Alexou1209/RPI-Pico-oscillocope-and-logic-analizer/3d_models/Case.FCStd

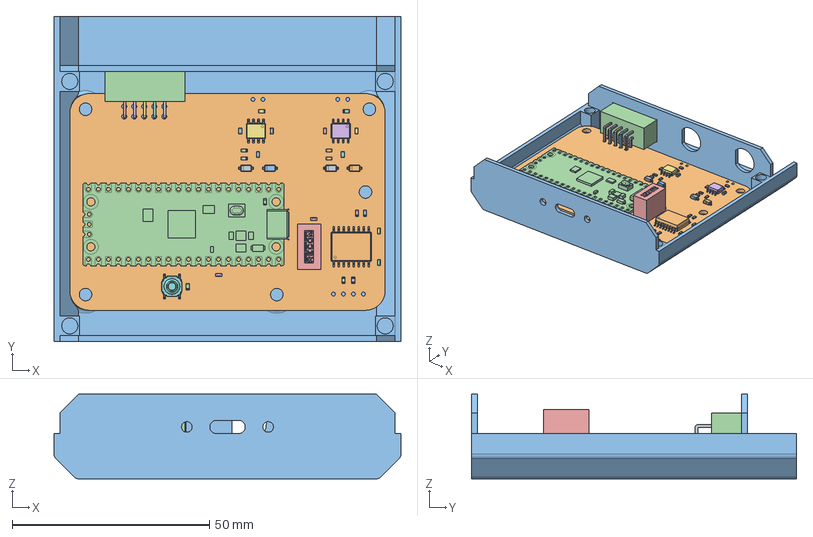
[picture p2: CAD file, 2026-10-25]
3d_models/Case.FCStd
88.0 x 82.5 x 21.5 mm
R_0603_1608Metric
SOIC-16W_7.5x10.3mm_P1.27mm
D_SOD-123
R_0603_1608Metric002
C_0603_1608Metric
R_0603_1608Metric004
SOIC-8_3.9x4.9mm_P1.27mm
R_0603_1608Metric006
RFM_potting
RFM_pin1(-Vin)
RFM_pin2(+Vin)
RFM_pin3(-Vout)
RFM_case
RFM_pin4(+Vout)
C_0603_1608Metric002
C_0603_1608Metric004
D_SOD-125
D_SOD-127
R_0603_1608Metric008
R_0603_1608Metric010
R_0603_1608Metric012
SOIC-8_3.9x4.9mm_P1.27mm002
R_0603_1608Metric014
SWT0220
D_SOD-129
R_0603_1608Metric016
R_0603_1608Metric018
RaspberryPi_Pico_Module_KiCad
R_0603_1608Metric020
C_0603_1608Metric006
C_0603_1608Metric008
R_0603_1608Metric022
C_0603_1608Metric010
R_0603_1608Metric024
R_0603_1608Metric026
LeadsArray
LeadsArray001
LeadsArray002
LeadsArray003
LeadsArray004
LeadsArray006
LeadsArray007
LeadsArray008
LeadsArray009
LeadsArray010
R_0603_1608Metric028
C_0603_1608Metric012
TSSOP-20_4.4x6.5mm_P0.65mm
Pico_Discovery-unsaved-export-cLAQ7U_PCB
Case_bottom
