Alexou1209/RPI-Pico-oscillocope-and-logic-analizer/3d_models/Pico_Discovery.step

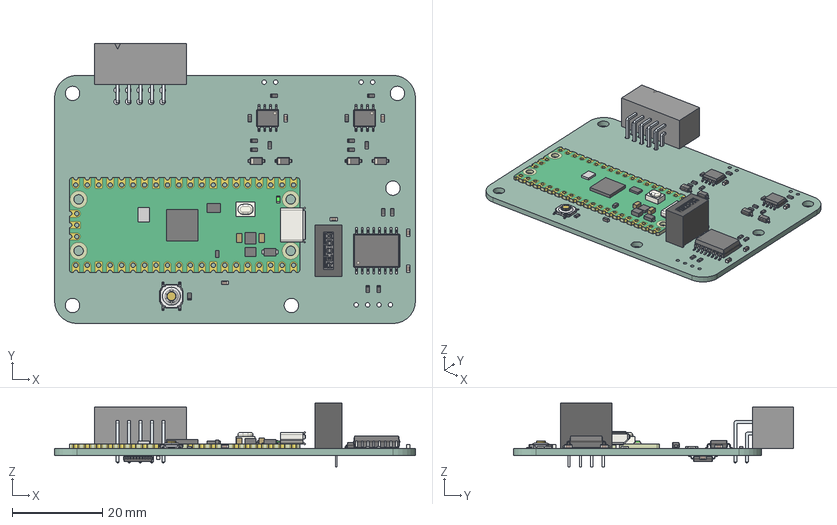
[picture p3: CAD file, 2026-10-25]
3d_models/Pico_Discovery.step
80.0 x 62.1 x 14.1 mm
R_0603_1608Metric x 15
SOIC-16W_7.5x10.3mm_P1.27mm
D_SOD-123 x 4
C_0603_1608Metric x 7
SOIC-8_3.9x4.9mm_P1.27mm x 2
RFM_potting
RFM_pin1(-Vin)
RFM_pin2(+Vin)
RFM_pin3(-Vout)
RFM_case
RFM_pin4(+Vout)
SWT0220
RaspberryPi_Pico_Module_KiCad
LeadsArray x 2
TSSOP-20_4.4x6.5mm_P0.65mm
Pico_Discovery-unsaved-export-cLAQ7U_PCB
