Alexou1209/RPI-Pico-oscillocope-and-logic-analizer/hardware/RPI_Pico_Oscilloscope.kicad_pcb

## KiCad design hardware/RPI_Pico_Oscilloscope.kicad_pcb (2026-10-25)

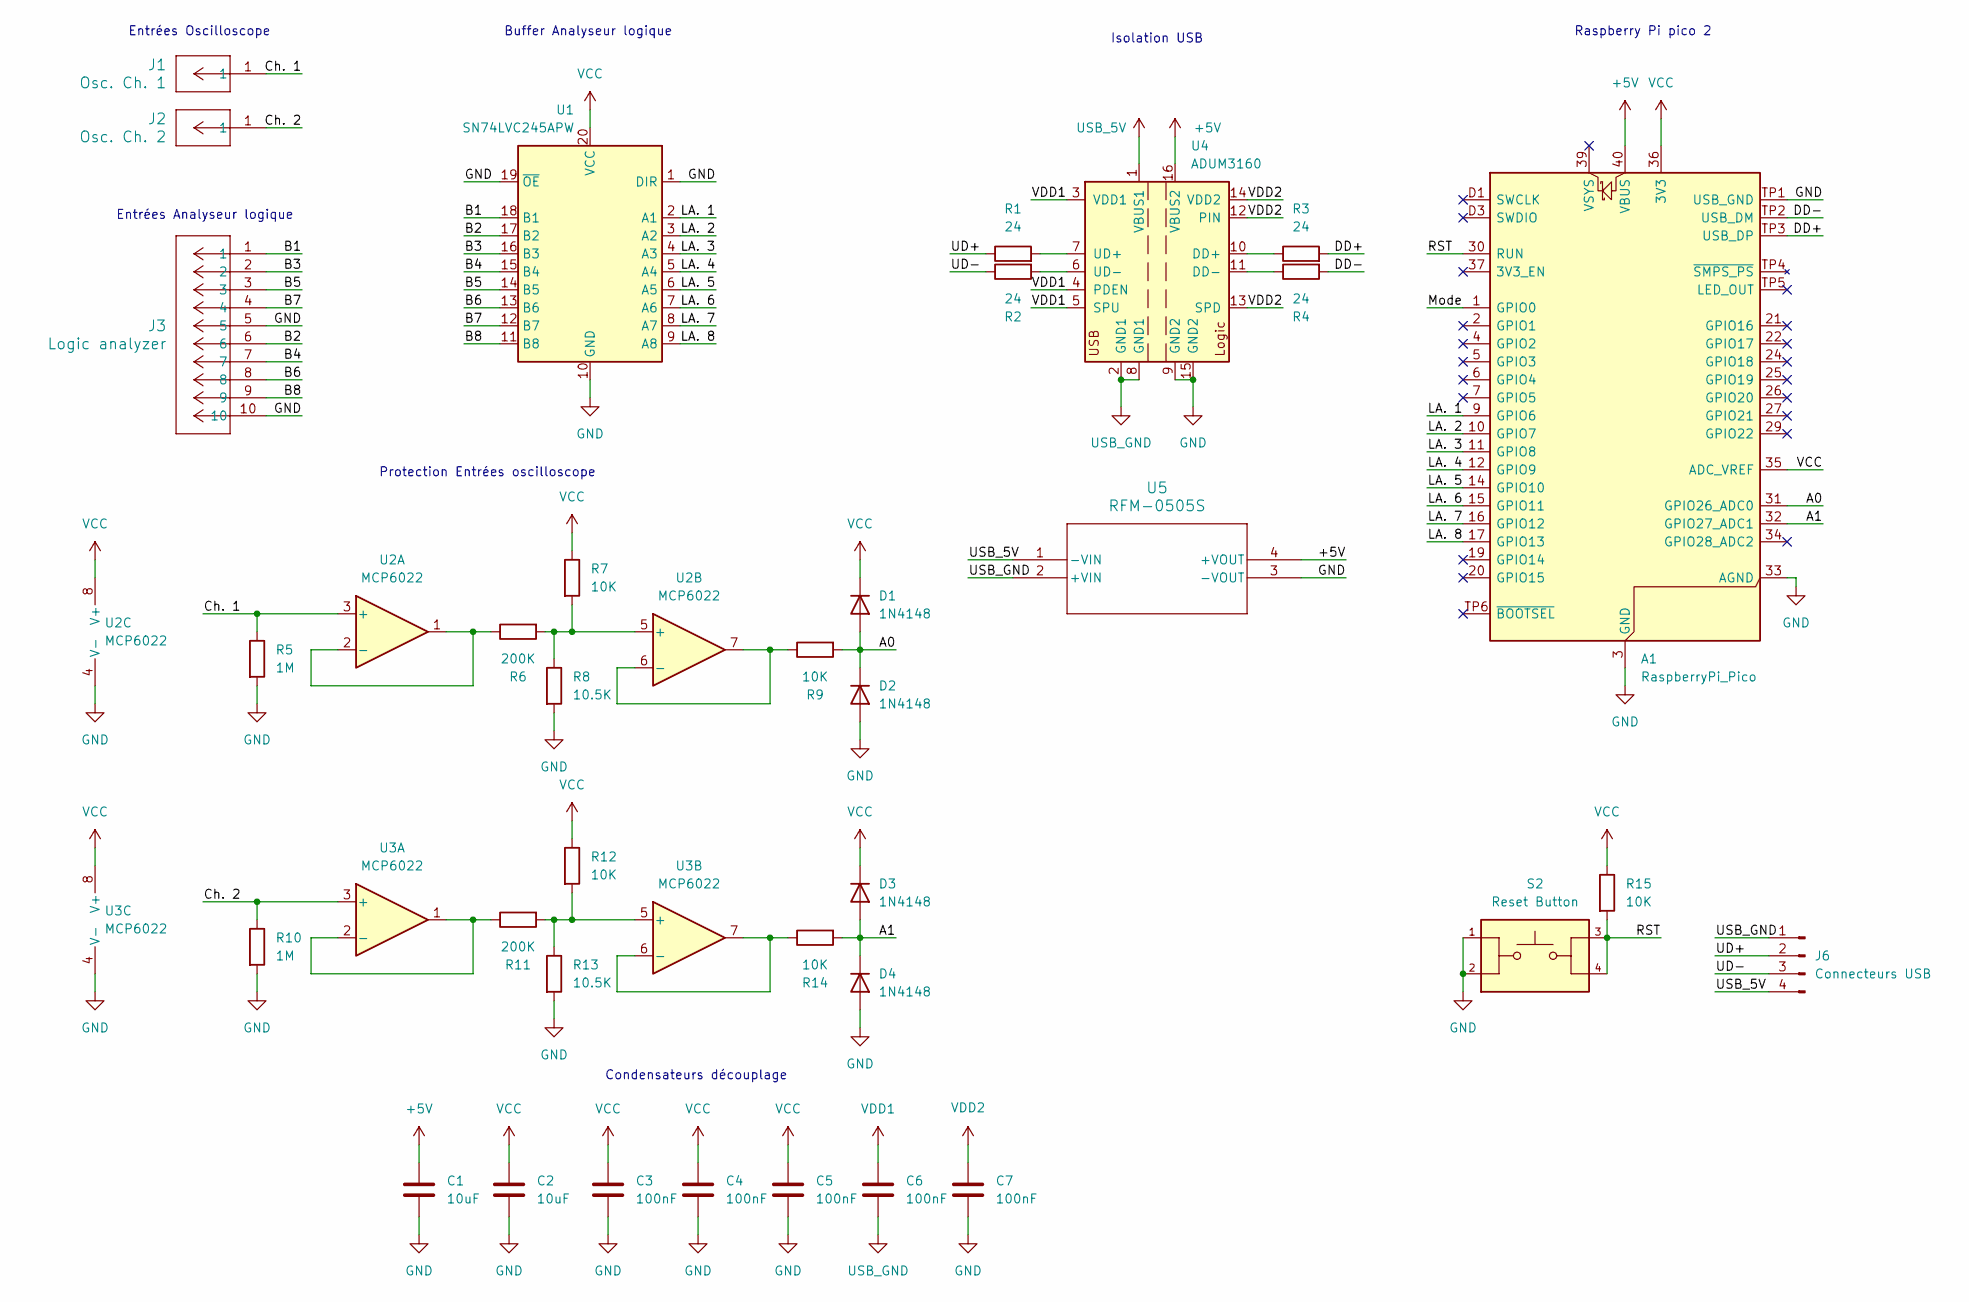
[picture p4: schematic RPI_Pico_Oscilloscope.kicad_sch, Pico_Discovery]

Parts:
A1: RaspberryPi_Pico; RaspberryPi_Pico_SMD
C1, C2: 10uF; C_0603_1608Metric_Pad1.08x0.95mm_HandSolder
C3, C4, C5, C6, C7: 100nF; C_0603_1608Metric_Pad1.08x0.95mm_HandSolder
D1, D2, D3, D4: 1N4148; D_SOD-123
J1: Osc. Ch. 1; PinHeader_1x02_P2.54mm_Vertical
J2: Osc. Ch. 2; PinHeader_1x02_P2.54mm_Vertical
J3: Logic analyzer; CONN_302-R101_OST
J6: Connecteurs USB; PinHeader_1x04_P2.54mm_Vertical
R1, R2, R3, R4: 24; R_0603_1608Metric_Pad0.98x0.95mm_HandSolder
R5, R10: 1M; R_0603_1608Metric_Pad0.98x0.95mm_HandSolder
R6, R11: 200K; R_0603_1608Metric_Pad0.98x0.95mm_HandSolder
R7, R9, R12, R14, R15: 10K; R_0603_1608Metric_Pad0.98x0.95mm_HandSolder
R8, R13: 10.5K; R_0603_1608Metric_Pad0.98x0.95mm_HandSolder
S2: Reset Button; SW_SWT0220-016016GSA_REVA; PARTREV A
U1: SN74LVC245APW; TSSOP-20_4.4x6.5mm_P0.65mm
U2, U3: MCP6022; SOIC-8_3.9x4.9mm_P1.27mm
U4: ADUM3160; SOIC-16W_7.5x10.3mm_P1.27mm
U5: RFM-0505S; SIP4_RFM_RCP

Connections:
+5V: A1.40 (VBUS), C1.2, U4.16 (VBUS2), U5.4 (+VOUT)
/<NO NET>: A1.30 (RUN), R15.2, S2.3, S2.4
/A0: A1.31 (GPIO26_ADC0), D1.2 (A), D2.1 (K), R9.2
/A1: A1.32 (GPIO27_ADC1), D3.2 (A), D4.1 (K), R14.2
/B1: J3.1, U1.18 (B1)
/B2: J3.6, U1.17 (B2)
/B3: J3.2, U1.16 (B3)
/B4: J3.7, U1.15 (B4)
/B5: J3.3, U1.14 (B5)
/B6: J3.8, U1.13 (B6)
/B7: J3.4, U1.12 (B7)
/B8: J3.9, U1.11 (B8)
/Ch. 1: J1.1 (1_1), R5.1, U2.3 (+)
/Ch. 2: J2.1 (1_1), R10.1, U3.3 (+)
/DD+: A1.TP3 (USB_DP), R3.2
/DD-: A1.TP2 (USB_DM), R4.2
/LA. 1: A1.9 (GPIO6), U1.2 (A1)
/LA. 2: A1.10 (GPIO7), U1.3 (A2)
/LA. 3: A1.11 (GPIO8), U1.4 (A3)
/LA. 4: A1.12 (GPIO9), U1.5 (A4)
/LA. 5: A1.14 (GPIO10), U1.6 (A5)
/LA. 6: A1.15 (GPIO11), U1.7 (A6)
/LA. 7: A1.16 (GPIO12), U1.8 (A7)
/LA. 8: A1.17 (GPIO13), U1.9 (A8)
/Mode: A1.1 (GPIO0)
/UD+: J6.2, R1.1
/UD-: J6.3, R2.1
GND: A1.3 (GND), A1.8 (GND), A1.13 (GND), A1.18 (GND), A1.23 (GND), A1.28 (GND), A1.33 (AGND), A1.38 (GND), A1.D2 (GND), A1.TP1 (USB_GND), C1.1, C2.1, C3.1, C4.1, C5.1, C7.1, D2.2 (A), D4.2 (A), J3.5, J3.10, R5.2, R8.2, R10.2, R13.2, S2.1, S2.2, U1.1 (DIR), U1.10 (GND), U1.19 (~OE), U2.4 (V-), U3.4 (V-), U4.9 (GND2), U4.15 (GND2), U5.3 (-VOUT)
unnamed: R6.1, U2.1, U2.2 (-)
unnamed: R6.2, R7.2, R8.1, U2.5 (+)
unnamed: R9.1, U2.6 (-), U2.7
unnamed: R11.1, U3.1, U3.2 (-)
unnamed: R11.2, R12.2, R13.1, U3.5 (+)
unnamed: R14.1, U3.6 (-), U3.7
unnamed: R3.1, U4.10 (DD+)
unnamed: R4.1, U4.11 (DD-)
unnamed: R1.2, U4.7 (UD+)
unnamed: R2.2, U4.6 (UD-)
USB_5V: J6.4, U4.1 (VBUS1), U5.1 (-VIN)
USB_GND: C6.1, J6.1, U4.2 (GND1), U4.8 (GND1), U5.2 (+VIN)
VCC: A1.35 (ADC_VREF), A1.36 (3V3), C2.2, C3.2, C4.2, C5.2, D1.1 (K), D3.1 (K), R7.1, R12.1, R15.1, U1.20 (VCC), U2.8 (V+), U3.8 (V+)
VDD1: C6.2, U4.3 (VDD1), U4.4 (PDEN), U4.5 (SPU)
VDD2: C7.2, U4.12 (PIN), U4.13 (SPD), U4.14 (VDD2)

Notes on the sheet:
Condensateurs découplage
Raspberry Pi pico 2
Protection Entrées oscilloscope
Entrées Oscilloscope
Isolation USB
Entrées Analyseur logique
Buffer Analyseur logique

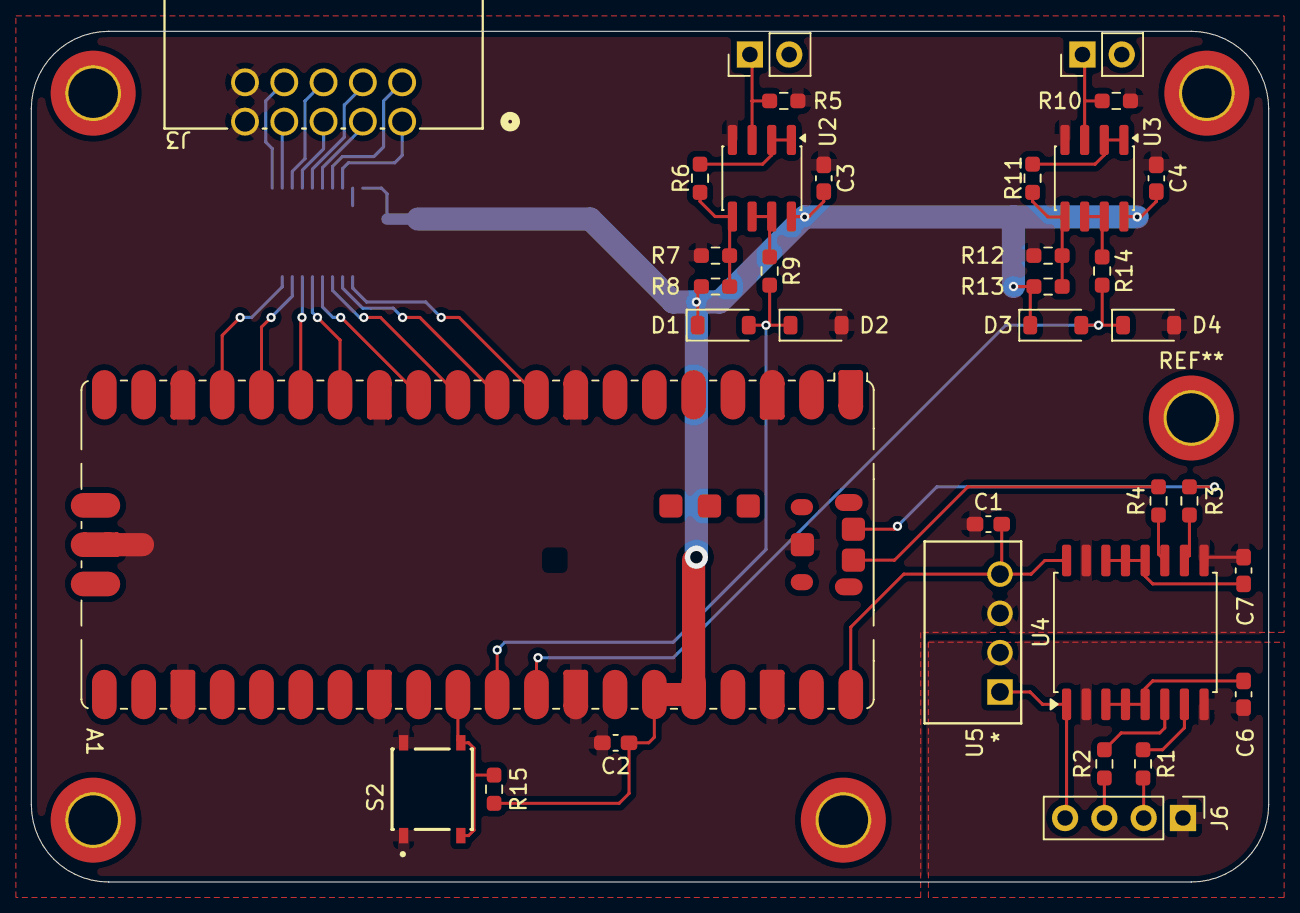
[picture p5: board RPI_Pico_Oscilloscope.kicad_pcb from above]

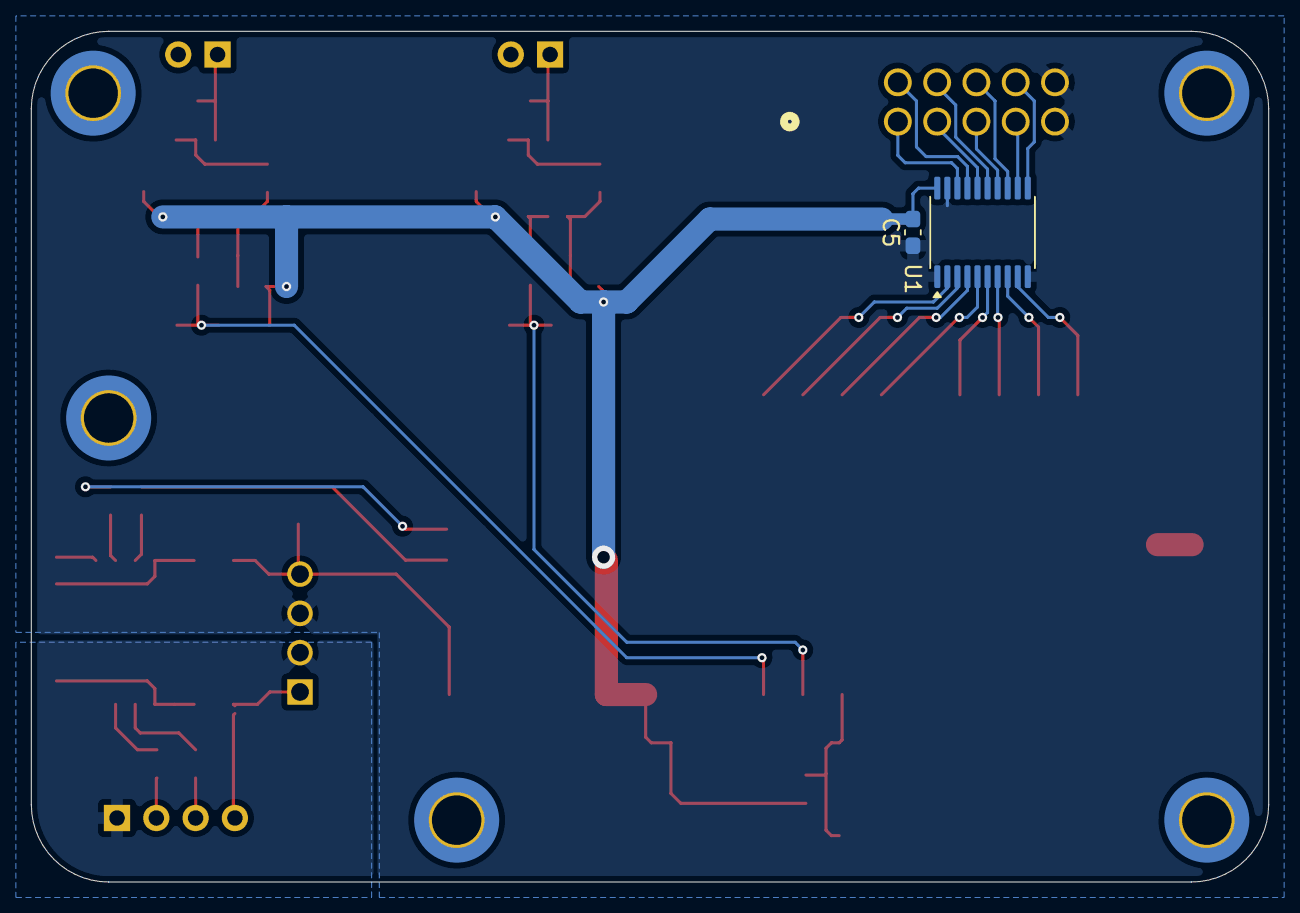
[picture p6: board RPI_Pico_Oscilloscope.kicad_pcb from below]

Board: 2 copper layers, 80.0 x 55.0 mm, 37 parts (2 on the bottom side), 42 nets.
