Alexou1209/RPI-Pico-oscillocope-and-logic-analizer/(commit log)

2026-10-25 first PCB version
    [Case.FCStd, Pico_Discovery.step, RPI_Pico_Oscilloscope.kicad_pcb, RPI_Pico_Oscilloscope.kicad_sch]
2026-10-25 added PCB render picture
2026-10-25 added case 3d files
    [Case.FCStd]
